picogrid/Strain-Gauge-POC-Board-V1/Strain Gauge POC Board V1/Strain Gauge POC Board V1/Strain Gauge POC Board V1.step

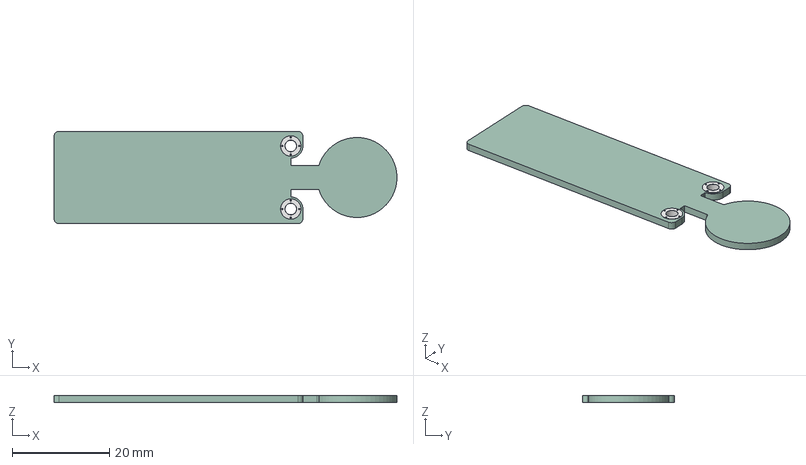
[picture p1: CAD file, 2025-06-04]
Strain Gauge POC Board V1/Strain Gauge POC Board V1/Strain Gauge POC Board V1.step
70.7 x 19.0 x 1.52 mm
Strain Gauge POC Board V1_pad
Strain Gauge POC Board V1_PCB
