picogrid/Strain-Gauge-POC-Board-V1/Strain Gauge POC Board V1/Strain Gauge POC Board V1/Strain Gauge POC Board V1.kicad_pcb

## KiCad design Strain Gauge POC Board V1/Strain Gauge POC Board V1/Strain Gauge POC Board V1.kicad_pcb (2025-06-05)

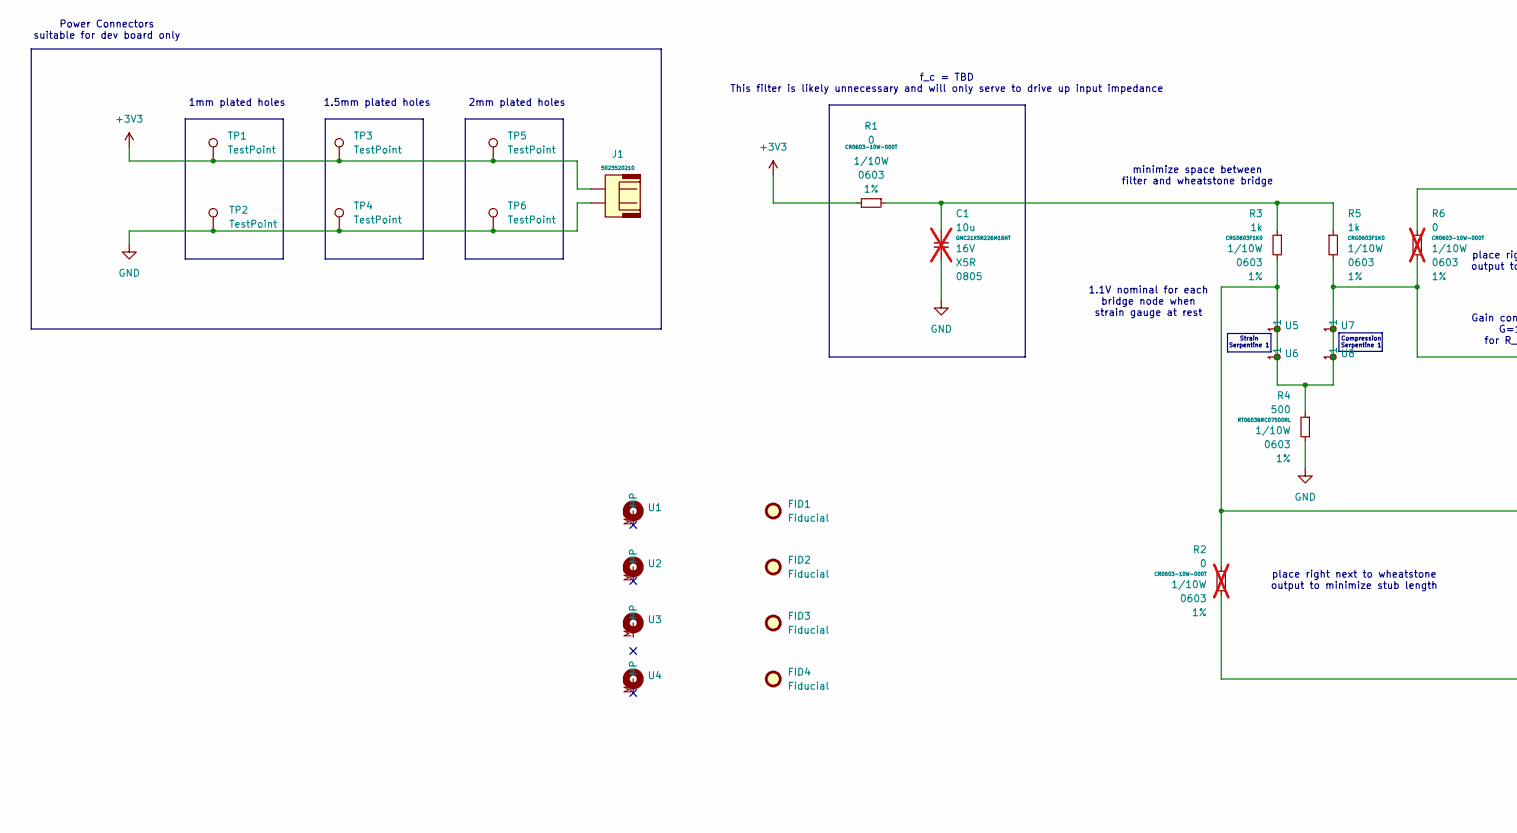
[picture p2: schematic Single Bridge 1.kicad_sch, part in row 1, column 1]

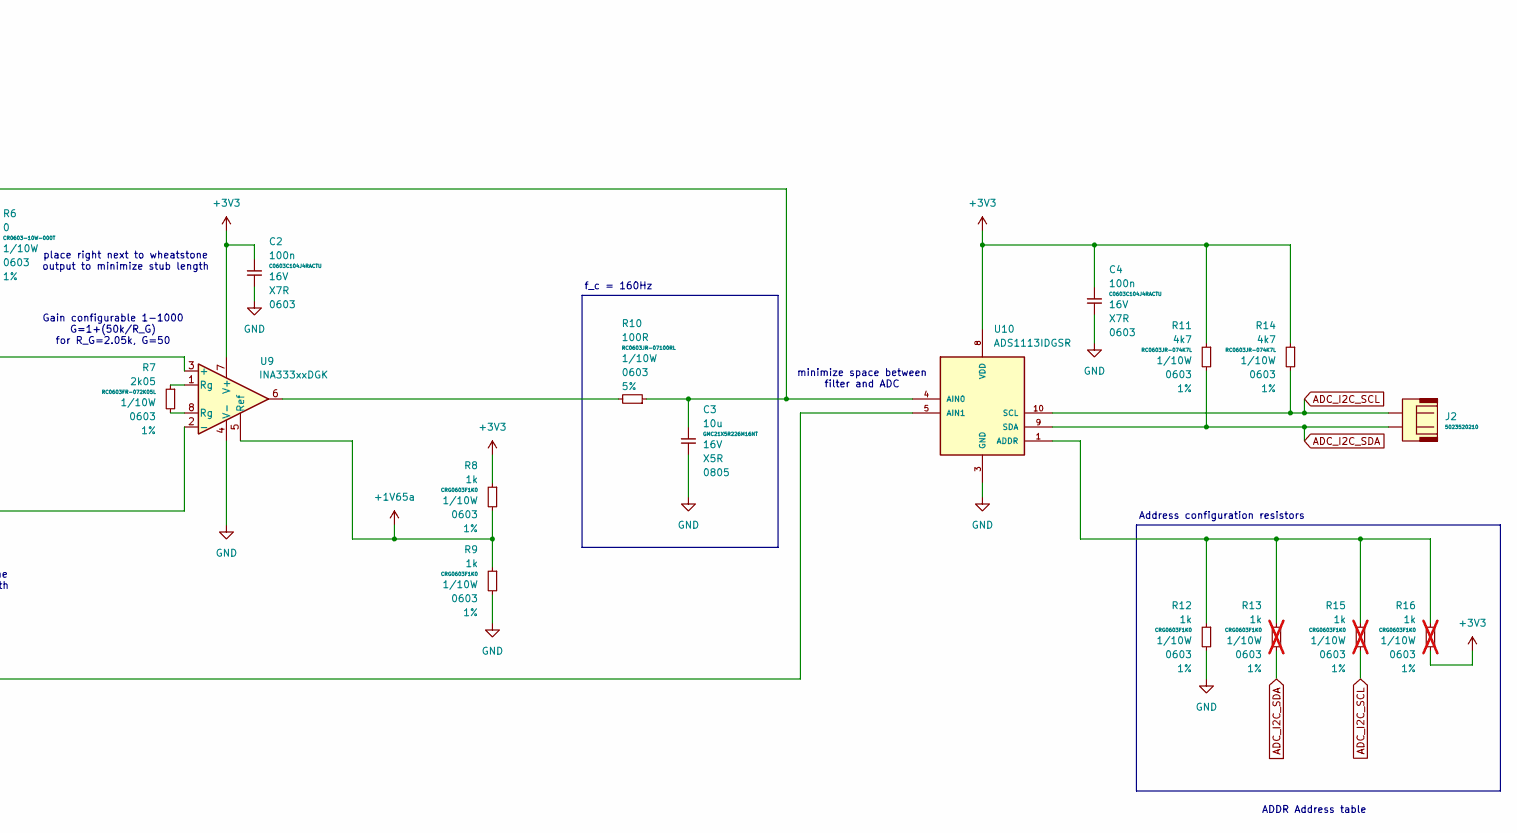
[picture p3: schematic Single Bridge 1.kicad_sch, part in row 1, column 2]

Parts:
C1: 10u; C_0805_2012Metric; Voltage 16V; Mfr PN GMC21X5R226M16NT; not fitted
C2, C4: 100n; C_0603_1608Metric; Voltage 16V; Mfr PN C0603C104J4RACTU
C3: 10u; C_0805_2012Metric; Voltage 16V; Mfr PN GMC21X5R226M16NT
FID1, FID2, FID3, FID4: Fiducial; Fiducial_0.5mm_Mask1mm
J1, J2: 502352-0210; Molex_DuraClik_5023520210_1x02_MP_P2.00mm_Right_Angle; Mfr PN 5023520210
R1: 0; R_0603_1608Metric; Tolerance 1%; Mfr PN CR0603-10W-000T
R2, R6: 0; R_0603_1608Metric; Tolerance 1%; Mfr PN CR0603-10W-000T; not fitted
R3, R5, R8, R9, R12: 1k; R_0603_1608Metric; Tolerance 1%; Mfr PN CRG0603F1K0
R4: 500; R_0603_1608Metric; Tolerance 1%; Mfr PN RT0603BRC07500RL
R7: 2k05; R_0603_1608Metric; Tolerance 1%; Mfr PN RC0603FR-072K05L
R10: 100R; R_0603_1608Metric; Tolerance 5%; Mfr PN RC0603JR-07100RL
R11, R14: 4k7; R_0603_1608Metric; Tolerance 1%; Mfr PN RC0603JR-074K7L
R13, R15, R16: 1k; R_0603_1608Metric; Tolerance 1%; Mfr PN CRG0603F1K0; not fitted
TP1, TP2: TestPoint; TestPoint_THTPad_D2.0mm_Drill1.0mm
TP3, TP4: TestPoint; TestPoint_THTPad_D3.0mm_Drill1.5mm
TP5, TP6: TestPoint; TestPoint_THTPad_D4.0mm_Drill2.0mm
U1, U2, U3, U4: MountingHole_3.2mm_M2_Pad_Via
U5, U6, U7, U8: TestPoint_Pad_D0.15mm
U9: INA333xxDGK; VSSOP-8_3x3mm_P0.65mm
U10: ADS1113IDGSR; SOP50P490X110-10N

Connections:
+1V65a: R8.2, R9.1, U9.5 (Ref)
+3V3: C2.1 (+), C4.1 (+), J1.1, R1.2, R8.1, R11.1, R14.1, R16.2, TP1.1, TP3.1, TP5.1, U9.7 (V+), U10.8 (VDD)
ADC_I2C_SCL: J2.2, R14.2, R15.2, U10.10 (SCL)
ADC_I2C_SDA: J2.1, R11.2, R13.2, U10.9 (SDA)
GND: C1.2 (-), C2.2 (-), C3.2 (-), C4.2 (-), J1.2, R4.2, R9.2, R12.2, TP2.1, TP4.1, TP6.1, U9.4 (V-), U10.3 (GND)
unnamed: C1.1 (+), R1.1, R3.1, R5.1
unnamed: C3.1 (+), R6.1, R10.1, U10.4 (AIN0)
unnamed: R7.1, U9.1 (Rg)
unnamed: R7.2, U9.8 (Rg)
unnamed: R10.2, U9.6
unnamed: R2.1, R3.2, R4.1, R5.2, R6.2, U5.1, U6.1, U7.1, U8.1, U9.2 (-), U9.3 (+)
unnamed: R12.1, R13.1, R15.1, R16.1, U10.1 (ADDR)
unnamed: R2.2, U10.5 (AIN1)

Notes on the sheet:
Compression Serpentine 1
f_c = 160Hz
Power Connectors suitable for dev board only
Address configuration resistors
1mm plated holes
2mm plated holes
1.1V nominal for each bridge node when strain gauge at rest
Gain configurable 1-1000 G=1+(50k/R_G) for R_G=2.05k, G=50
minimize space between filter and ADC
place right next to wheatstone output to minimize stub length
ADDR Address table
Strain Serpentine 1
1.5mm plated holes
f_c = TBD This filter is likely unnecessary and will only serve to drive up input impedance
minimize space between filter and wheatstone bridge

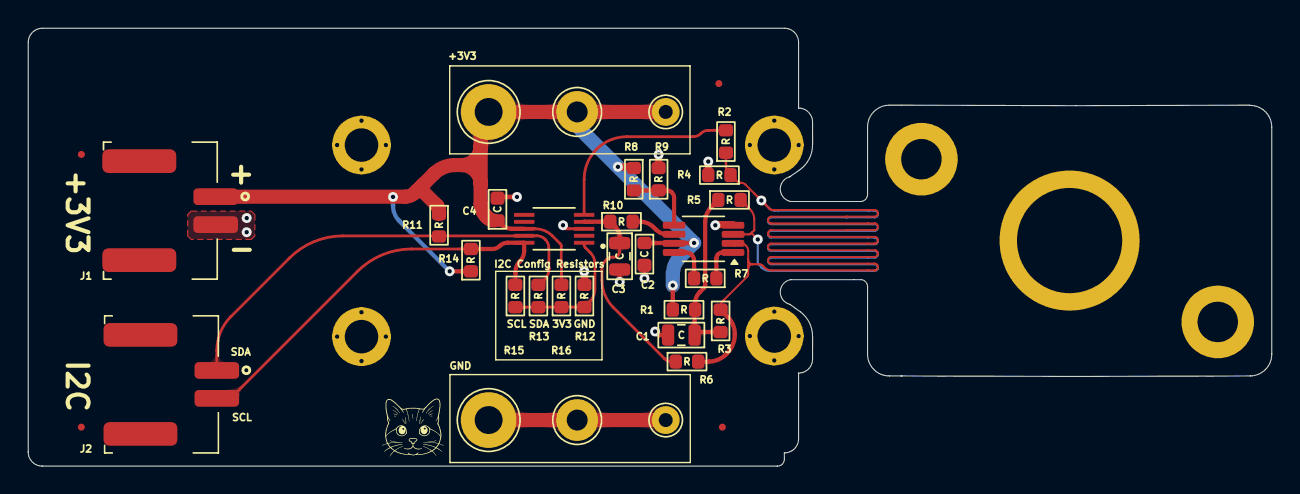
[picture p4: board Strain Gauge POC Board V1.kicad_pcb from above]

Board: 4 copper layers, 89.2 x 31.4 mm, 42 parts (0 on the bottom side), 13 nets.
