picogrid/Strain-Gauge-POC-Board-V1/(commit log)

2025-06-04 initial git creation from previous work
    [Double Bridge 1.kicad_sch, Single Bridge 1.kicad_sch, Strain Gauge POC Board V1.kicad_pcb, Strain Gauge POC Board V1.kicad_sch, Strain Gauge POC Board V1.step]
2025-06-04 Working now
    [Double Bridge 1.kicad_sch, Strain Gauge POC Board V1.kicad_pcb]
2025-06-04 bulk of first draft done
    [Single Bridge 1.kicad_sch, Strain Gauge POC Board V1.kicad_pcb, Strain Gauge POC Board V1.kicad_sch]
2025-06-05 further dev
    [Strain Gauge POC Board V1.kicad_pcb]
2025-06-05 almost finished first draft
    [Strain Gauge POC Board V1.kicad_pcb]
2025-06-05 Ready for fab sans watermark
    [Single Bridge 1.kicad_sch, Strain Gauge POC Board V1.kicad_pcb]
2025-06-05 final save before duplication
    saved draft in templates
    [Strain Gauge POC Board V1.kicad_pcb]
2025-06-05 ready for fab
    [Single Bridge 1.kicad_sch, Strain Gauge POC Board V1.kicad_pcb]
2025-06-05 ready for fab for real this time
    [Strain Gauge POC Board V1.kicad_pcb]
2025-06-05 fabbed edition
    [Strain Gauge POC Board V1.kicad_pcb]
